PatKlaassen/Switch8MKIII/README.md

# Switch8 MKIII
8 Channel guitar pedal switcher - Switch8

The switch unit is build around the Arduino Mega, it can switch 8 loops, has a midi out and can switch amp settings using a trs connector.

File list:
GuitarSwitch-mkIII-v0.5.ino
- Arduino sketch

Swicth8-MkIII-switch-wiring.png
- Dwitch wiring diagram

Switch8-mkIII-Back-v1.pub
- msPublisher file containing the layout connection panel

Switch8-mkIII-Top-v1.pub
- msPublisher file containing the layout switch panel

Switch8-mkIII-BoM-fiinal.pub
- msExcel file containing the bill of materials and additional wiring information

Link to Google Photos album:
https://goo.gl/photos/JYGqpnPPz51WmjSG7

Link to short video on the MkII model (LCD display):
https://youtu.be/dVaR2lphJOY
