PatKlaassen/Switch8MKIII/Switch8-mkIII-BoM-final.xlsx

Sheet: Parts
Switch8 MKIII stompbox switcher
Overview of all used parts
Item | Description | pcs € | Nr | Ship | Total € | Prio | Total | Ontvangen
Oled Display (https://www.ebay.com/itm/1-5inch-OLED-Display-Module-128x128-16bit-SPI-I2C-for-Raspberry-Pi-Arduino-STM32/253421173636) | 1,5 inch OLED 128x128 i2c | 12.87 | 1 |  | 12.87 | 1 | 12.87
USB adapter (https://www.amazon.com/Adapter-Breakout-Extension-Electrical-Components/dp/B09WC9BNMM) | USB connector board | 0.99 | 1 |  | 0.99 | 1 | 0.99
Arduino Mega (https://nl.grandado.com/products/mega2560-core-mini-2560-arduino-compatibel-3-3v-5v-voor-arduino-mega-2560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) | Arduino Mega Core | 13.99 | 1 |  | 13.99 | 1 | 13.99
Relay 8 Signal (https://www.ebay.com/itm/8-DPDT-Signal-Relay-Module-Board-DC24V-Version-for-PIC-Arduino-8051-AVR-MCU-/372146869494) | 8 channel signal relay | 35.99 | 1 |  | 35.99 | 1 | 35.99
Most relay boards are for switching 230VAC, these boards are rubbish for audio switching. I'm not able to find the data relay board.
As you can see from the price (35,99) it was pretty pricy
Relay 4 (https://www.ebay.com/itm/4-Four-Channel-Relay-Module-DC-5V-Optocoupler-For-Arduino-PIC-ARM-AVR-DSP/281686248144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) | 4 channel relay with optocoupler amp switching | 2.49 | 1 |  | 2.49 | 1 | 2.49
I2C IO Ext (https://www.ebay.com/itm/PCF8574-IO-Expansion-Board-I-O-Expander-I2C-Bus-Evaluation-Development-Module/400453349150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) | I2C 16 port I/O extension | 1.7 | 2 |  | 3.4 | 1 | 3.4
Midi socket | 5-pin DIN, Female, Black - Zwart | 5 | 1 |  | 5 | 1 | 5
SPST Switch (http://www.ebay.com/itm/1X-SPST-Momentary-Soft-Touch-Push-Button-Electric-Guitar-Stomp-Foot-Pedal-Switch-/201597073007) | Stomp switches silent | 1.87 | 21 |  | 39.27 | 1 | 39.27
Blue LED 100 (http://www.ebay.com/itm/100PCS-5mm-Blue-Round-High-Power-Super-Bright-Water-Clear-LED-Leds-Lamp-Bulb-/131854073708) | Superbright Blue LEDs 5mm | 1.46 | 0 |  | 0 | 1 | 0
LED Mount 5mm (https://www.ebay.com/itm/100pcs-5mm-Black-Plastic-LED-Holders-Case-Cup-Mounting/231613401962?epid=1131402501) | 100 pcs | 1.26 | 1 |  | 1.26 | 1 | 1.26
Resistors (http://www.ebay.com/itm/100-pcs-Carbon-Film-Resistors-1-4W-0-25W-0-25-Watt-4-7K-Ohm-4-7Kohm-4K7-5-/151335900231) | 100 pcs 0.25W 4.7K Ohm +/-5% | 0.99 | 0 |  | 0 | 1 | 0
Jumper cable mm (http://www.ebay.com/itm/40PCS-Dupont-wire-jumper-cables-20cm-2-54MM-male-to-male-1P-1P-For-Arduino-/151926399258) | 40 pcs mm | 1.25 | 3 |  | 3.75 | 1 | 3.75
Jumper cable mf (http://www.ebay.com/itm/40PCS-DuPont-Wire-Jumper-Connect-Wire-Male-to-Female-1P-1P-2-54mm-Length-20CM-/201323399819) | 40 pcs mf | 0.99 | 3 |  | 2.97 | 1 | 2.97
DC chassis (http://www.ebay.com/itm/10PCS-DC-Power-Supply-Jack-Socket-Female-Panel-Mount-Connector-5-5-x-2-1mm-/201728104380) | 2 pcs, replaced these with a single multi connector | 1.18 | 1 |  | 1.18 | 1 | 1.18
Connector jack (https://www.tonefactory.nl/switchcraft-little-jax-mono-jack) | Guitar connector switchcraft | 1.55 | 22 | 5.95 | 40.05 | 1 | 40.05
Enclosure (http://www.metalpoint.nl/plaatwerkprofielen/c-profiel.html) | Custom 1,5 mm stainless steel enclosure | 40 | 2 |  | 80
PowderCoat (https://www.zamro.nl/product/D1EED/7102-ral3001-400ml-hoogglans-rood) | RAL 3001 | 45 | 1 |  | 45
1/4 Stereo (https://www.ebay.com/itm/5PCS-6-35mm-1-4-6Pin-Female-Stereo-Jack-Socket-Panel-PCB-Welding/192373152016) | Stereo jack 1/4 | 1.54 | 1 |  | 1.54
Decal (https://nl.aliexpress.com/item/10pcs-lot-Laser-Water-Slide-Decal-Paper-No-Need-Varnish-Water-Transfer-Paper-White-Background/32743806805.html) | Decal sticker paper | 10 | 0 |  | 0
USB power | power for relays | 12 | 0 |  | 0
Imbus Bol (http://www.ebay.com/itm/172680089781?var=471479287818) | OLED connection bolts m3x16 | 2 | 0 |  | 0
Switch8 total |  |  |  |  | 289.75 |  | 163.21 |  | 350
Pedal Power (https://www.thomann.de/nl/harley_benton_powerplant_iso_2_pro.htm) | Harley Benton ISO PowerPlant | 69 | 2 | 138
Midi connectoren (https://www.thomann.de/nl/neutrik_nys322.htm?ref=search_rslt_Neutrik+Rean+NYS+322_121360_0) | Neutrik Rean NYS 322 | 1.5 | 7 | 10.5
Midi cable (https://www.thomann.de/nl/sommer_cable_sc_stage_22_highflex_sw.htm) | Sommer Cable SC Stage 22 Highflex SW | 0.98 | 8 | 7.84
Patch cable (https://www.thomann.de/nl/sommer_cable_tricone_mkii.htm?glp=1) | Sommer Tricone MKII | 0.77 | 8 | 6.16
Jacks (https://www.thomann.de/nl/thomann_sk140_winkel_klinke.htm) | Thomann SK140 Jack mono Angled | 0.99 | 35 | 34.65
Effectsloop cable (https://www.thomann.de/nl/sommer_cable_onyx_2025_schwarz.htm) | Sommer Cable Onyx 2025 BK | 1.15 | 8 | 9.2
 |  |  |  |  |  |  |  |  |  | Cable | Diameter
Power and patch cables total |  |  |  | 206.35 |  | 105.95 |  | 150 |  | Cordial CPK 220 BK | 4.7
 |  |  | Total | 496.1 |  |  |  |  |  | Cordial CIK 122 BK | 6.1
 |  |  |  |  |  |  |  |  |  | 760 | 200
 |  |  |  |  |  |  |  |  |  | 3.8 | 1

Sheet: Dimensions
Enclosure hole dimensions and locations
 |  |  |  |  |  |  |  |  |  |  | Aansluiting relayboard
 | mm |  |  |  |  |  |  |  |  |  | Power
Part | o | l | h |  |  |  |  |  |  |  | gnd | groen
Large switch | 12 |  |  |  |  |  |  |  |  |  | vcc | geel | oranje
Small switch | 7 |  |  |  |  |  |  |  |  |  | jd-vcc | blauw
LCD Display |  | 71 | 24
LED | 6.2
Audio jack | 9
DC power jack | 15.9
Stereo Jack | 11
Midi | 15
 |  |  |  |  | 245
1121
Width top | 500
Heigth top | 50
Width bottom | 503
Height bottom | 51.5 |  |  |  |  |  |  |  |  |  |  |  |  |  |  | 35
Relay boards 8 | 280
Relay board 4 | 75 |  |  |  |  |  | 23 |  |  |  |  | Lengte LCD |  | 34 | (Lengte)
Arduino | 115 |  |  |  |  |  | 14 |  |  |  |  | Breedte LCD |  | 37 | (Breedte)
Sum | 470
 |  |  |  |  |  |  |  |  |  |  |  | Gaten horizontaal |  | 40
 |  |  |  |  |  |  |  |  |  |  |  | Gaten verticaal |  | 33
Top B
Depth | 170 |  |  |  | Center positions |  | Select LED | Loop |  |  |  | hart positie LCD |  |  | Mute |  | Mode
 |  |  |  | D 12,1 | X | Switch Y | LED Y D 6,5 | D12,1 | LED D6,5 |  |  | x | y |  | X | Y | X | Y
Width enclosure | 500 |  |  | Select 1 | 25.0 | 14 | 37 | 149 | 126 |  |  | 465 | 81.5 |  | 25.0 | 81.5 | 89.3 | 81.5
x first switch | 25 |  |  | Select 2 | 89.3 | 14 | 37 | 149 | 126 |  |  |  |  |  | D | 12.1 | D | 12.1
x last switch | 475 |  |  | Select 3 | 153.6 | 14 | 37 | 149 | 126 |  |  | Gaten LCD 3.1mm
lengte | 450 |  |  | Select 4 | 217.9 | 14 | 37 | 149 | 126 |  |  | L1 |  |  | Down |  | Up
Destance between switches | 64.3 |  |  | Select 5 | 282.1 | 14 | 37 | 149 | 126 |  |  | X | Y |  | X | Y | X | Y
 |  |  |  | Select 6 | 346.4 | 14 | 37 | 149 | 126 |  |  | 445 | 98 |  | 346.4 | 81.5 | 410.7 | 81.5
Distance led | 20 |  |  | Select 7 | 410.7 | 14 | 37 | 149 | 126 |  |  | L2 |  |  | Down | 12.1 | D | 12.1
 |  |  |  | Select 8 | 475.0 | 14 | 37 | 149 | 126 |  |  | X | Y
 |  |  |  |  |  |  |  |  |  |  |  | 445 | 65
 |  |  |  |  |  |  |  |  |  |  |  | L3 |  |  | Mode LED 6,5
 |  |  |  |  |  | 137 | 68.5 | 80.5 |  |  |  | X | Y |  | X | Y
 |  |  |  |  |  |  |  |  |  |  |  | 485 | 65 |  | 121.4 | 81.5
 |  |  |  |  |  |  |  |  |  | 81.5 |  | L4
 |  |  |  |  |  |  |  |  |  |  |  | X | Y
 |  |  |  |  |  |  |  |  |  |  |  | 485 | 98
Panel side A
Nr of connectors | 21
Nr on single row | 16
Distance | 30
Heigth | 50
 | x | y | D
Relay mid | 482 | 25
Relay length | 13
Relay width | 20.2
Midi | 370.0 | 18.5 | 15.1
Amp sw | 345.0 | 18.5 | 11
Input | 320.0 | 25 | 9
Tuner | 305.0 | 13 | 9
Channel 1 send | 290.0 | 25 | 9
Channel 1 return | 275.0 | 13 | 9
Channel 2 send | 260.0 | 25 | 9
Channel 2 return | 245.0 | 13 | 9
Channel 3 send | 230.0 | 25 | 9
Channel 3 return | 215.0 | 13 | 9
Channel 4 send | 200.0 | 25 | 9
Channel 4 return | 185.0 | 13 | 9
Channel 5 send | 170.0 | 25 | 9
Channel 5 return | 155.0 | 13 | 9
Channel 6 send | 140.0 | 25 | 9
Channel 6 return | 125.0 | 13 | 9
Channel 7 send | 110.0 | 25 | 9
Channel 7 return | 95.0 | 13 | 9
Channel 8 send | 80.0 | 25 | 9
Channel 8 return st | 65.0 | 13 | 9
fx loop out | 50.0 | 25 | 9
fx loop in | 35.0 | 13 | 9
Output | 20.0 | 25 | 9
Cost top part including holes |  | 32.75
Bottom part | hart
Length | 170
Size A height | 51.5
Size B depth | 503
Size C Height | 51.5
Side C | x | y |  |  | 27.5
USB | 142.5 | 41
 | Dimensions
 | Length | Width
 | 8 | 5
 | x | y
Cool openings |  |  |  | Length | 1.5
 | 14 | 25 |  | Width | 30
 | 18 | 25
 | 22 | 25
 | 26 | 25
 | 30 | 25
 | 34 | 25
 | 38 | 25
 | 42 | 25
 | 46 | 25
 | 50 | 25
 | 54 | 25
 | 58 | 25
 | 62 | 25
 | 66 | 25
Side A | X | Y
Cool openings |  |  |  | Length | 1.5
 | 14 | 25 |  | Width | 30
 | 18 | 25
 | 22 | 25
 | 26 | 25
 | 30 | 25
 | 34 | 25
 | 38 | 25
 | 42 | 25
 | 46 | 25
 | 50 | 25
 | 54 | 25
 | 58 | 25
 | 62 | 25
 | 66 | 25
Bottom B
 | X | Y
Arduino
 | Fixed with saddles |  |  |  |  |  |  |  |  |  |  |  |  |  |  |  |  |  | X
 | X | Y | D
4 relay board 1 | d 3,1
Top right | 85 | 250 | 3.1 |  |  | width | 69
Bottom right | 129 | 250 | 3.1 |  |  | height | 44
Hole 7 | 85 | 319 | 3.1
Hole 7 | 129 | 319 | 3.1
8 relay board | d 3,1 |  |  | 17
Top right | 85 | 336 | 3.1 |  |  | width | 144
Bottom right | 151.5 | 336 | 3.1 |  |  | height | 66.5
Top left | 85 | 480 | 3.1
Bottom left | 151.5 | 480 | 3.1
USB port
 | Middle x | 142.5
 | width | 21
Top left | 132 | 18
Top right | 153 | 18
Cost bottom part | 27.17

Sheet: Resistors
LED resistors |  | Amps | no of leds | Total Amps |  | Source V | 5
Wit | 10000 | 0.0005 | 2 | 0.001
Groen | 10000 | 0.0005 | 2 | 0.001
blauw | 2300 | 0.002173913043 | 10 | 0.02173913043
rood | 2000 | 0.0025 | 2 | 0.005
 |  |  |  | 0.02873913043 | A
 |  |  |  | 28.73913043 | mA
 |  |  | res | 173.97882
 |  |  | power | 0.14

Sheet: Wiring
Wiring
Arduino serial communication
Arduino pin | Core pin
19 | 16 |  | Midi data
20 | 17 | gray | I2c sda
21 | 18 | purple | I2c scl
Arduino
Preset/Loops buttons
Arduino Pin | New Pin | Core Pin | Color | Button
22 | 22 | 74 | white | Common presets
23 | 23 | 71 | yellow | Common loops
13 | 36 | 89 | blue | Down
12 | 37 | 90 | white | Up
11 | 38 | 93 | black | Mute
10 | 39 | 66 | purple | Mode
9 | 40 | 91 | gray | 8
8 | 41 | 92 | brown | 7
7 | 42 | 36 | red | 6
6 | 43 | 35 | groen | 5
5 | 44 | 34 | orange | 4
4 | 45 | 33 | yellow | 3
3 | 46 | 32 | groen | 2
2 | 47 | 31 | blue | 1
Relay pins |  |  |  | Send |  | Send St |  | Return |  | Return st
Arduino | Core Pin | color | Channel | Board | Pin | Board | Pin | Board | Pin | Board | Pin
35 | 88 |  | Tip | 1 | 4
34 | 87 |  | Ring | 1 | 3
33 | 86 | yellow | Mute | 1 | 2
32 | 85 | groen | ch 1 | 1 | 1 |  |  | 2 | 8
31 | 84 | blue | ch 2 | 2 | 7 |  |  | 2 | 6
30 | 83 | purple | ch 3 | 2 | 5 |  |  | 2 | 4
29 | 65 | gray | ch 4 | 2 | 3 |  |  | 2 | 2
28 | 68 | white | ch 5 | 2 | 1 |  |  | 3 | 8
27 | 67 | black | ch 6 | 3 | 7 |  |  | 3 | 6
26 | 70 | brown | ch 7 | 3 | 5 |  |  | 3 | 4 | 3 | 3
25 | 69 | red | Ch 8 | 3 | 2 | 3 | 1 | 4 | 4 | 4 | 3
24 | 72 | orange | Mute | 4 | 2
Pin power supply |  |  | inside multi connector location
1 |  | +5V | top right
2 |  | gnd | bottom right
3 |  | gnd | bottom left
4 |  | +9V | top left
Midi info (https://www.midi.org/specifications/item/table-1-summary-of-midi-message)
Midi
1 | nc
2 | nc
3 | gnd
4 | +5V
5 | Arduino TX1

Sheet: PinUsage
Pin Usage
OrgMega | Full | OrgCore | NewCore | NewMega | Color | Description
19 | TX1/D19 | 16 | 16 | D19 / TX1 |  | TX1 midi
20 | SDA/D20 | 17 | 17 | D20 / SDA | orange | SDA I2C
21 | SCL/D21 | 18 | 18 | D21 / SCL | yellow | SCL I2C
10 | D9 |  | 23 | D9 | red | Mode LED
40 | D40 | 91 | 26 | D11 | Orange | Clock SLI
39 | D39 | 66 | 27 | D12 | Yellow | Data SLI
38 | D38 | 93 | 28 | D13 | Blue | CS SLI
37 | D37 | 90 | 29 | D49 | Green | DC SLI
36 | D36 | 89 | 30 | D48 | White | Reset SLI
13 | D13 | 28 | 31 | D47 | blue | Keypad col Down
12 | D12 | 27 | 32 | D46 | green | Keypad col Up
11 | D11 | 26 | 33 | D45 | orange | Keypad col Mute
10 | D10 | 25 | 34 | D44 | yellow | Keypad col Mode
25 | D25 | 69 | 65 | D29 | brown | Relay pin 1
26 | D26 | 70 | 66 | D39 | red | Relay pin 2
27 | D27 | 67 | 67 | D27 | orange | Relay pin 3
28 | D28 | 68 | 68 | D28 | yellow | Relay pin 4
29 | D29 | 65 | 69 | D25 | green | Relay pin 5
30 | D30 | 83 | 70 | D26 | blue | Relay pin 6
31 | D31 | 84 | 71 | D23 | purple | Relay pin 7
32 | D32 | 85 | 72 | D24 | grey | Relay pin 8
33 | D33 | 86 | 77 | D52 | green | Mute relay input/tuner output/ground
34 | D34 | 87 | 78 | D51 | blue | Amp reverb relay, IN3
35 | D35 | 88 | 79 | D50 | purple | amp gain relay, IN4
22 | D22 | 74 | 83 | D30 | Green | Keypad Row Presets
23 | D23 | 71 | 84 | D31 | Blue | Keypad Row Loops
2 | D2 | 7 | 85 | D32 | brown | Keypad col 1
3 | D3 | 8 | 86 | D33 | black | Keypad col 2
4 | D4 | 3 | 87 | D34 | white | Keypad col 3
5 | D5 | 6 | 88 | D35 | grey | Keypad col 4
6 | D6 | 20 | 89 | D36 | purple | Keypad col 5
7 | D7 | 21 | 90 | D37 | blue | Keypad col 6
8 | D8 | 22 | 91 | D40 | green | Keypad col 7
9 | D9 | 23 | 92 | D41 | white | Keypad col 8
