PatKlaassen/Switch8MKIII/Switch8-MkIII-switch-wiring.png

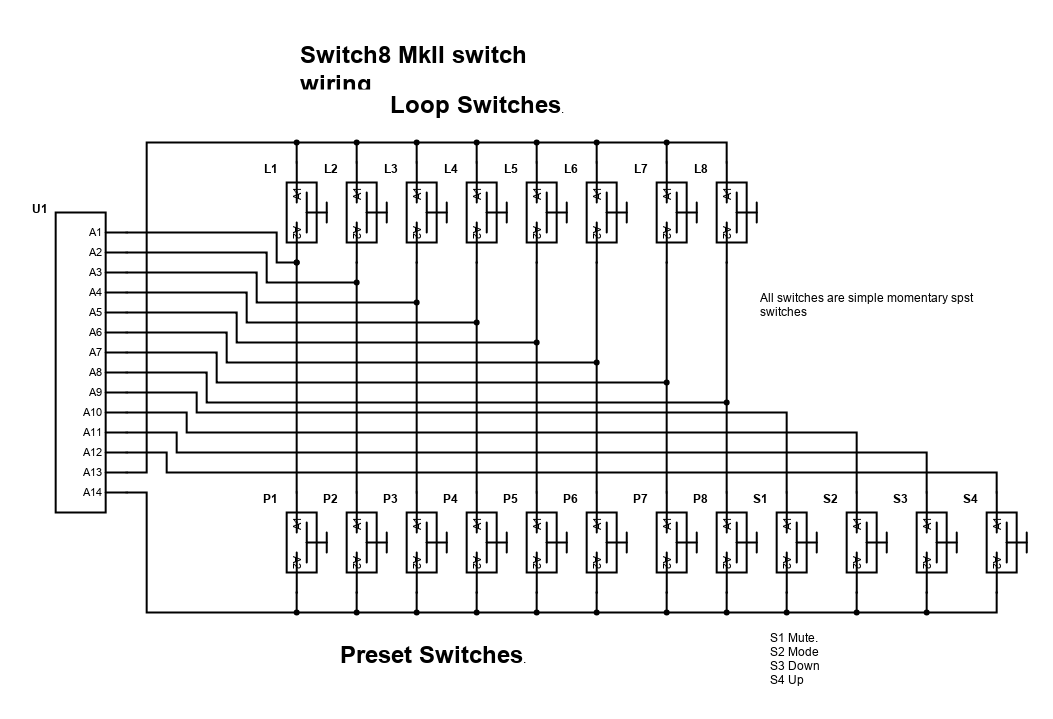
Switch8-MkIII-switch-wiring.png
